FREEVSE/hardware/mainboard_ESP32 DevBoard.pdf

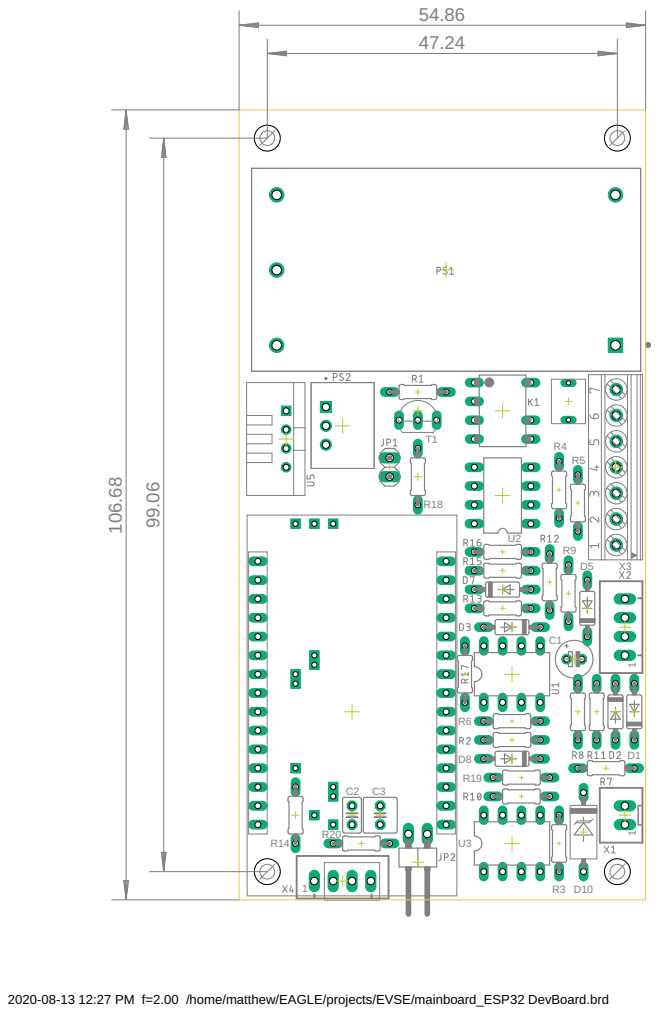
[picture p1: page 1]

2020-08-13 12:27 PM f=2.00 /home/matthew/EAGLE/projects/EVSE/mainboard_ESP32 DevBoard.brd
