FREEVSE/hardware/mainboard_ESP32 DevBoard.brd

## EAGLE design mainboard_ESP32 DevBoard.brd (2021-01-30)

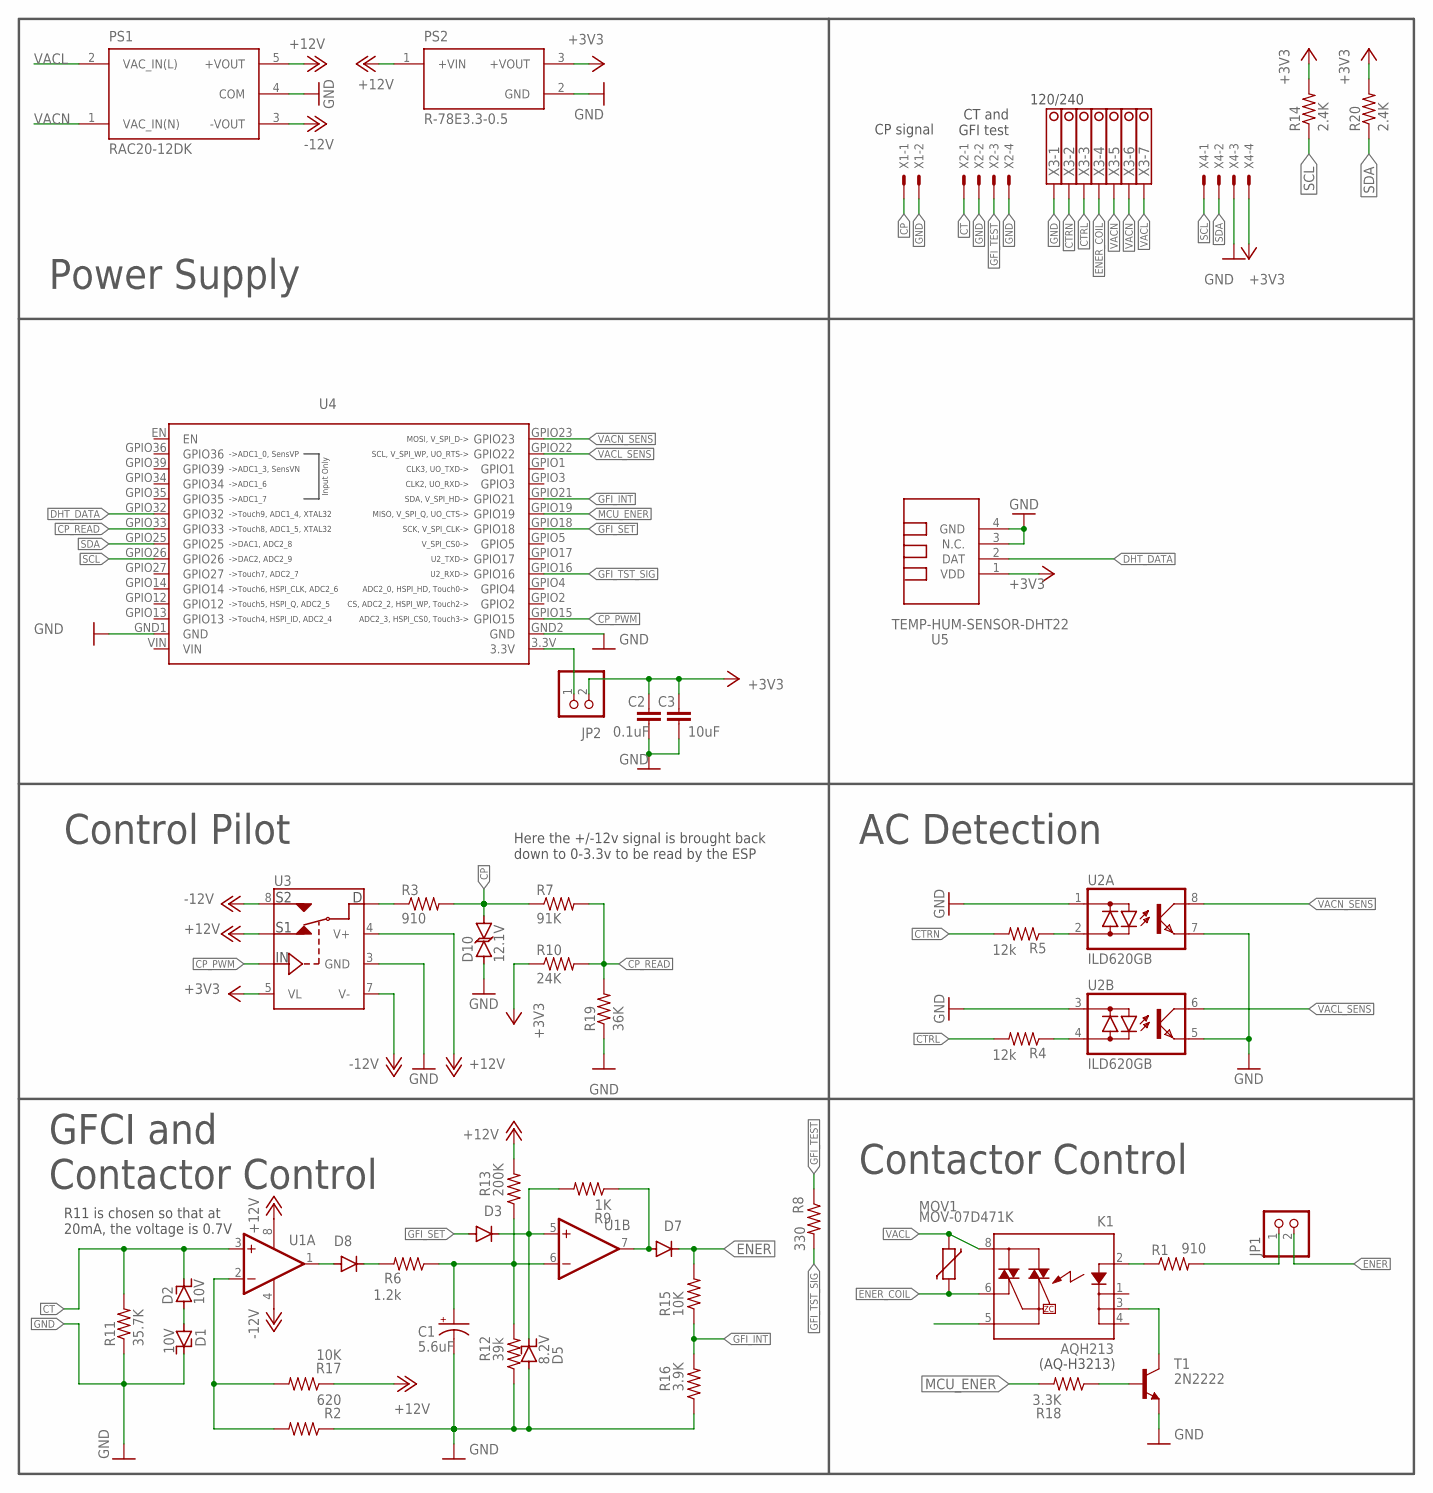
[picture p2: schematic mainboard_ESP32 DevBoard.sch]

Parts:
C1: 5.6uF; E2-5
C2: 0.1uF; C025-025X050
C3: 10uF; C025-050X050
D1, D2: 10V; DO35-7
D3, D7, D8: 1N4148DO35-7; DO35-7
D5: 8.2V; DO35-7
D10: 12.1V; DO15
JP1: PINHD-1X2; 1X02
JP2: PINHD-1X2/90; 1X02/90
K1: AQH213; DIL07
MOV1: MOV-07D471K; DISC-7
PS1: RAC20-12DK; CONV_RAC20-12DK
PS2: R-78E3.3-0.5; CONV_R-78E3.3-0.5
R1, R3: 910; 0204/7-L
R2: 620; 0204/7-L
R4, R5: 12k; 0204/7-L
R6: 1.2k; 0204/7-L
R7: 91K; 0204/7-L
R8: 330; 0204/7-L
R9: 1K; 0204/7-L
R10: 24K; 0204/7-L
R11: 35.7K; 0204/7-L
R12: 39k; 0204/7-L
R13: 200K; 0204/7-L
R14, R20: 2.4K; 0204/7-L
R15, R17: 10K; 0204/7-L
R16: 3.9K; 0204/7-L
R18: 3.3K; 0204/7-L
R19: 36K; 0204/7-L
T1: 2N2222; TO92-EBC
U1: LM833N; DIL08-LONG
U2: ILD620GB; DIL8
U3: DG419DJ-L; DIL08-LONG
U4: ESP32-DOIT-V1
U5: TEMP-HUM-SENSOR-DHT22
X1: JST-XH-02-PIN-LONG-PAD; JST-XH-02-PACKAGE-LONG-PAD
X2, X4: JST-XH-04-PIN-LONG-PAD; JST-XH-04-PACKAGE-LONG-PAD
X3: 1751293

Connections:
+3V3: C2.1, C3.1, JP2.2, PS2.3 (+VOUT), R10.1, R14.2, R20.2, U3.5 (VL), U5.1 (VDD), X4.4
+12V: PS1.5 (+VOUT), PS2.1 (+VIN), R13.2, R17.1, U1.8 (V+), U3.2 (S1), U3.4 (V+)
-12V: PS1.3 (-VOUT), U1.4 (V-), U3.7 (V-), U3.8 (S2)
CP: D10.C, R3.2, R7.1, X1.1
CP_PWM: U3.6 (IN), U4.GPIO15
CP_READ: R7.2, R10.2, R19.2, U4.GPIO33
CT: D2.C, R11.2, U1.3 (+IN), X2.1
CTRL: R4.2, X3.3
CTRN: R5.2, X3.2
DHT_DATA: U4.GPIO32, U5.2 (DAT)
ENER: D7.C, JP1.2, R15.2
ENER_COIL: K1.6 (DS3), MOV1.P$2 (2), X3.4
GFI_INT: R15.1, R16.2, U4.GPIO21
GFI_SET: D3.A, U4.GPIO18
GFI_TEST: R8.1, X2.3
GFI_TST_SIG: R8.2, U4.GPIO16
GND: C1.-, C2.2, C3.2, D1.C, D5.A, D10.A, PS1.4 (COM), PS2.2 (GND), R2.1, R11.1, R12.1, R16.1, R19.1, T1.E, U2.1 (AC1), U2.3 (AC1), U2.5 (E), U2.7 (E), U3.3 (GND), U4.GND1 (GND), U4.GND2 (GND), U5.3 (N.C.), U5.4 (GND), X1.2, X2.2, X2.4, X3.1, X4.3
MCU_ENER: R18.2, U4.GPIO19
unnamed: K1.2 (A), R1.1
unnamed: R2.2, R17.2, U1.2 (-IN)
unnamed: JP1.1, R1.2
unnamed: D7.A, R9.1, U1.7 (OUT)
unnamed: D1.A, D2.A
unnamed: D8.C, R6.2
unnamed: R3.1, U3.1 (D)
unnamed: C1.+, R6.1, R12.2, R13.1, U1.6 (-IN)
unnamed: JP2.1, U4.3.3V
unnamed: R18.1, T1.B
unnamed: D3.C, D5.C, R9.2, U1.5 (+IN)
unnamed: K1.3 (K1), T1.C
unnamed: D8.A, U1.1 (OUT)
unnamed: R5.1, U2.2 (AC2)
unnamed: R4.1, U2.4 (AC2)
SCL: R14.1, U4.GPIO26, X4.1
SDA: R20.1, U4.GPIO25, X4.2
VACL: K1.8 (DS1), MOV1.P$1 (1), PS1.2 (VAC_IN(L)), X3.7
VACL_SENS: U2.6 (C), U4.GPIO22
VACN: PS1.1 (VAC_IN(N)), X3.5, X3.6
VACN_SENS: U2.8 (C), U4.GPIO23
VIN: U4.VIN

Notes on the sheet:
Here the +/-12v signal is brought back down to 0-3.3v to be read by the ESP
Control Pilot
(AQ-H3213)
GFCI and Contactor Control
CP signal
CT and GFI test
120/240
Power Supply
R11 is chosen so that at 20mA, the voltage is 0.7V
AC Detection
Contactor Control

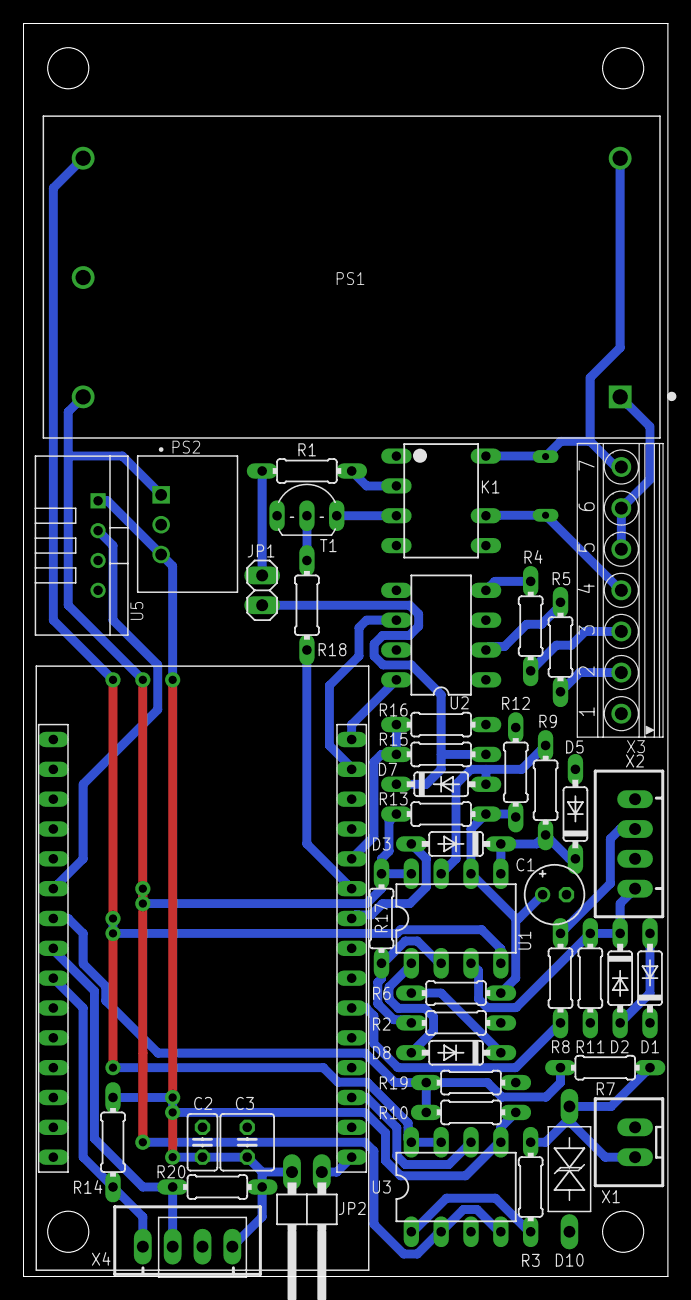
[picture p3: board mainboard_ESP32 DevBoard.brd from above]

Board: 2 copper layers, 54.9 x 106.7 mm, 46 parts (0 on the bottom side), 39 nets.
