FREEVSE/hardware/mainboard.brd

## EAGLE design mainboard.brd (2020-05-17)

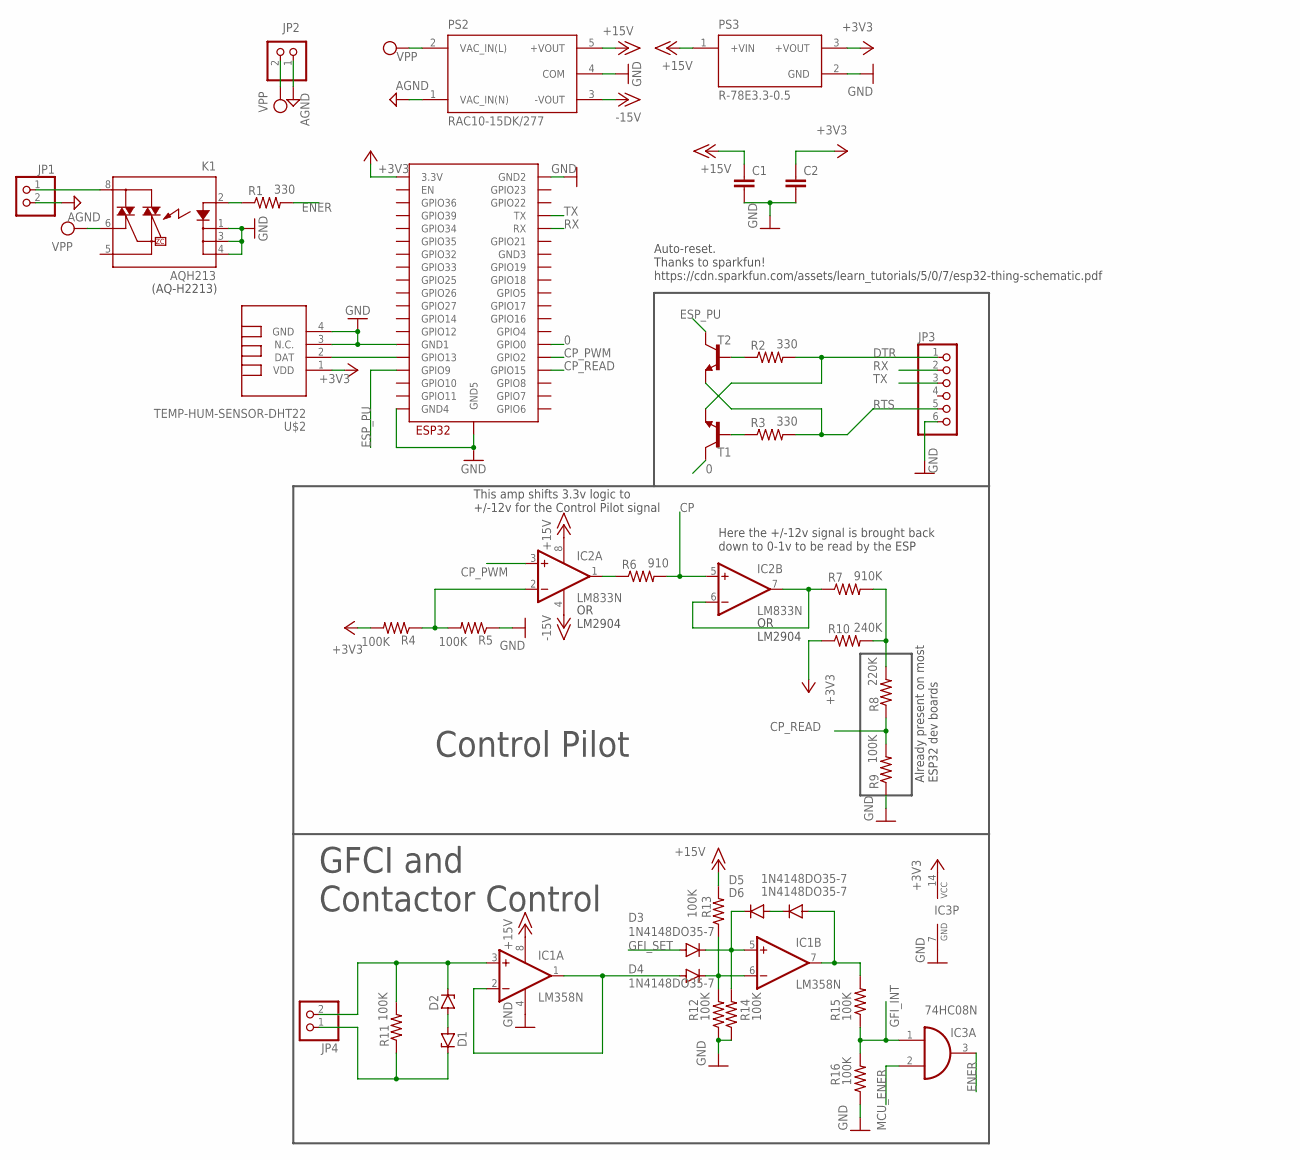
[picture p4: schematic mainboard.sch]

Parts:
C1, C2: C-EU025-025X050; C025-025X050
D1, D2: ZENER-DIODEDO34-7; DO34Z7
D3, D4, D5, D6: 1N4148DO35-7; DO35-7
IC1: LM358N; DIL08
IC2: LM833N; DIL08
IC3: 74HC08N; DIL14
JP1, JP2, JP4: PINHD-1X2; 1X02
JP3: PINHD-1X6; 1X06
K1: AQH213; DIL07
PS2: RAC10-15DK/277; CONV_RAC10-15DK/277
PS3: R-78E3.3-0.5; CONV_R-78E3.3-0.5
R1, R2, R3: 330; 0204/7
R4, R5, R9, R11, R12, R13, R14, R15, R16: 100K; 0204/7
R6: 910; 0204/7
R7: 910K; 0204/7
R8: 220K; 0204/7
R10: 240K; 0204/7
T1, T2: MMBT3904LT1-NPN-SOT23-BEC; SOT23-BEC
U$1: ESP32-WROOM
U$2: TEMP-HUM-SENSOR-DHT22

Connections:
0: T1.C, U$1.IO0 (GPIO0)
+3V3: C2.1, IC3.14 (VCC), PS3.3 (+VOUT), R4.2, R10.1, U$1.3V3 (3.3V), U$2.1 (VDD)
+15V: C1.1, IC1.8 (V+), IC2.8 (V+), PS2.5 (+VOUT), PS3.1 (+VIN), R13.2
-15V: IC2.4 (V-), PS2.3 (-VOUT)
AGND: JP1.2, JP2.1, PS2.1 (VAC_IN(N))
CP: IC2.5 (+IN), R6.2
CP_PWM: IC2.3 (+IN), U$1.IO2 (GPIO2)
CP_READ: R8.1, R9.2, U$1.IO15 (GPIO15)
DTR: JP3.1, R2.2, T1.E
ENER: IC3.3 (O), R1.2
ESP_PU: T2.C, U$1.SD2 (GPIO9)
GFI_INT: IC3.1 (I0), R15.1, R16.2
GFI_SET: D3.A
GND: C1.2, C2.2, IC1.4 (V-), IC3.7 (GND), JP3.6, K1.1 (K), K1.3 (K1), K1.4 (K2), PS2.4 (COM), PS3.2 (GND), R5.1, R9.1, R12.1, R14.1, R16.1, U$1.GND1, U$1.GND2, U$1.GND4, U$1.GND5, U$2.3 (N.C.), U$2.4 (GND)
MCU_ENER: IC3.2 (I1)
unnamed: K1.2 (A), R1.1
unnamed: JP1.1, K1.8 (DS1)
unnamed: U$1.IO13 (GPIO13), U$2.2 (DAT)
unnamed: D1.A, D2.A
unnamed: D2.C, IC1.3 (+IN), JP4.2, R11.2
unnamed: R2.1, T2.B
unnamed: R3.1, T1.B
unnamed: D4.A, IC1.1 (OUT), IC1.2 (-IN)
unnamed: D1.C, JP4.1, R11.1
unnamed: D6.A, IC1.7 (OUT), R15.2
unnamed: D5.A, D6.C
unnamed: D3.C, D5.C, IC1.5 (+IN), R14.2
unnamed: D4.C, IC1.6 (-IN), R12.2, R13.1
unnamed: IC2.2 (-IN), R4.1, R5.2
unnamed: IC2.1 (OUT), R6.1
unnamed: IC2.6 (-IN), IC2.7 (OUT), R7.1
unnamed: R7.2, R8.2, R10.2
RTS: JP3.5, R3.2, T2.E
RX: JP3.2, U$1.RX
TX: JP3.3, U$1.TX
VPP: JP2.2, K1.6 (DS3), PS2.2 (VAC_IN(L))

Notes on the sheet:
Already present on most ESP32 dev boards
This amp shifts 3.3v logic to +/-12v for the Control Pilot signal
Here the +/-12v signal is brought back down to 0-1v to be read by the ESP
OR LM2904
Auto-reset. Thanks to sparkfun! https://cdn.sparkfun.com/assets/learn_tutorials/5/0/7/esp32-thing-schematic.pdf
Control Pilot
(AQ-H2213)
GFCI and Contactor Control

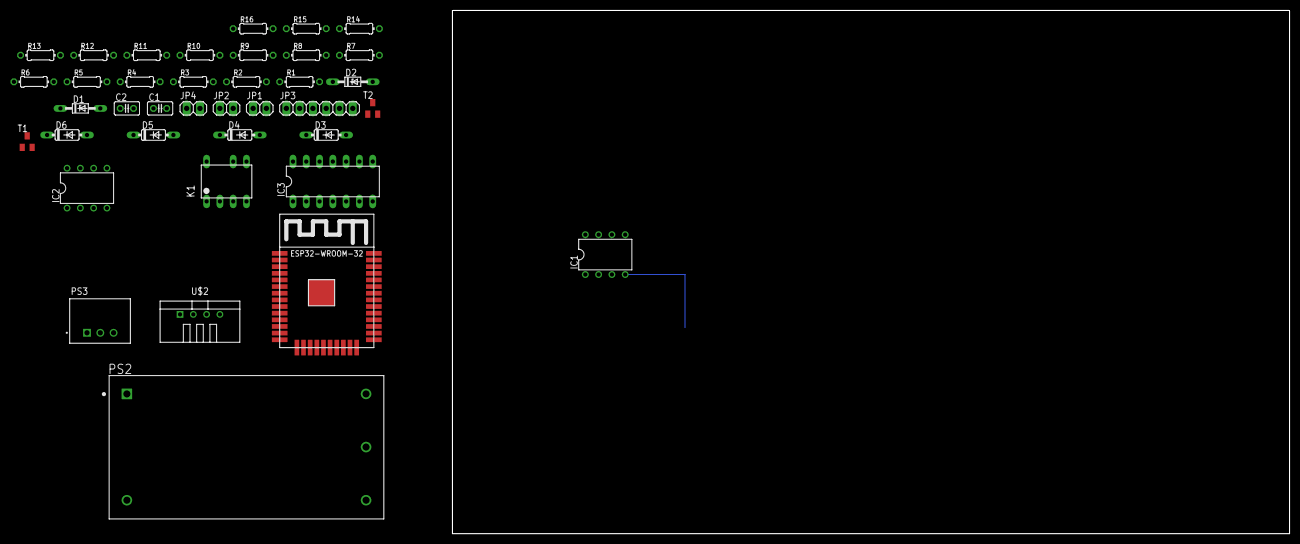
[picture p5: board mainboard.brd from above]

Board: 2 copper layers, 160.0 x 100.0 mm, 38 parts (0 on the bottom side), 34 nets.
