FREEVSE/hardware/(commit log)

2019-12-28 Completed routing first try of board. Some pin changes to fit the board better. Added puldown and jumper to prevent accidental coil energize.
    [mainboard_ESP32 DevBoard.brd, mainboard_ESP32 DevBoard.sch]
2019-12-29 Tweaked resistor on GFI circuit to allow 3.3v logic to set the latch
    [mainboard_ESP32 DevBoard.brd, mainboard_ESP32 DevBoard.sch]
2019-12-29 Added header to disconnect 3.3v output from esp to 3.3 rail. Added LED to indicate when contactor is energized. Added I2C connector. Added mounting holes.
    [mainboard_ESP32 DevBoard.brd, mainboard_ESP32 DevBoard.sch]
2019-12-31 Made all traces as big as possible. Pads also. Added some layers for CAM outputs. Added cam job file
    [mainboard_ESP32 DevBoard.brd, mainboard_ESP32 DevBoard.sch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]
2020-01-10 Updated ignore file. Made some adjustments after making the first board.
    [mainboard_ESP32 DevBoard.brd, mainboard_ESP32 DevBoard.sch]
2020-01-13 Made board single-sided friendly (P2P wiring needed). Tweaked some more resistor values. Added missing resistor to CP read level shifter
    [mainboard_ESP32 DevBoard.brd, mainboard_ESP32 DevBoard.sch]
2020-01-13 Corrected some via sizes
    [mainboard_ESP32 DevBoard.brd]
2020-01-16 Switched to +-12v, tweaked some R values to fit new psu. Also swapped CP opamp for an r2r one
    [mainboard_ESP32 DevBoard.brd, mainboard_ESP32 DevBoard.sch]
2020-02-11 Added DG419 in place of op amp.
    [mainboard_ESP32 DevBoard.brd, mainboard_ESP32 DevBoard.sch]
2020-04-30 Added optos for sensing L and N (l1/l2)
    [mainboard.brd, mainboard_ESP32 DevBoard.brd, mainboard_ESP32 DevBoard.sch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]
2020-05-11 Moved resistor on line sense for a tight, but good fit. cam outputs used for board 2
    [mainboard_ESP32 DevBoard.brd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]
2020-05-13 Added missing mains class
    [mainboard_ESP32 DevBoard.brd, mainboard_ESP32 DevBoard.sch]
2020-05-17 Added header for ac detection after contactor. Cleaned up schematic.
    [mainboard_ESP32 DevBoard.brd, mainboard_ESP32 DevBoard.sch]
2020-05-19 Swapped ac headers for one big one and added dedicated earth terminal
    [mainboard_ESP32 DevBoard.brd, mainboard_ESP32 DevBoard.sch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]
2020-06-25 Adjusted labels for PCB manufacture
    [mainboard_ESP32 DevBoard.brd]
2020-07-01 Cleaned labels
    [mainboard_ESP32 DevBoard.brd, mainboard_ESP32 DevBoard.sch]
2020-07-11 Reworked GFCI to account for noise on the line. Swapped out AND gate for 2 mosfets. Removed mostly useless caps from PSU outputs, caps should be closer to devices
    [mainboard_ESP32 DevBoard.brd, mainboard_ESP32 DevBoard.sch]
2020-07-17 Re-worked GFCI to be tolerant of transient spikes. Removed some components because of it
    [mainboard_ESP32 DevBoard.brd, mainboard_ESP32 DevBoard.sch]
2020-07-26 Completed new GFCI circuit
    [mainboard_ESP32 DevBoard.brd, mainboard_ESP32 DevBoard.sch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]
2020-07-31 Corrected some component values that were wrong during assembly
    [mainboard_ESP32 DevBoard.brd, mainboard_ESP32 DevBoard.sch]
2020-08-02 Creating the BOM on digikey uncovered some footprint mismatches. They havee been corrected
    [mainboard_ESP32 DevBoard.brd, mainboard_ESP32 DevBoard.sch]
2020-08-04 Added pullup resistors for I2C bus
    [mainboard_ESP32 DevBoard.brd, mainboard_ESP32 DevBoard.sch]
2020-08-13 Minor adjustments
    [mainboard_ESP32 DevBoard.brd]
2020-11-07 Not sure what I changed, but I trust myself...
    [mainboard_ESP32 DevBoard.brd, mainboard_ESP32 DevBoard.sch]
2021-01-30 Changed TVS diode to bi-directional P/N. Enlarged holes because fit was too tight.
    [mainboard_ESP32 DevBoard.brd, mainboard_ESP32 DevBoard.sch]
